boderu/cbEval.PwrSupply.Linear/README.md

# cbEval.PwrSupply.Linear

Evaluation-Board - basierend auf dem modularen Gehäuse von Camdenboss. Stromversorgung mit Linearreglern.
