boderu/cbEval.PwrSupply.Linear/cbEval.PwrSupply.Linear.kicad_pcb

## KiCad design cbEval.PwrSupply.Linear.kicad_pcb (2023-11-08)

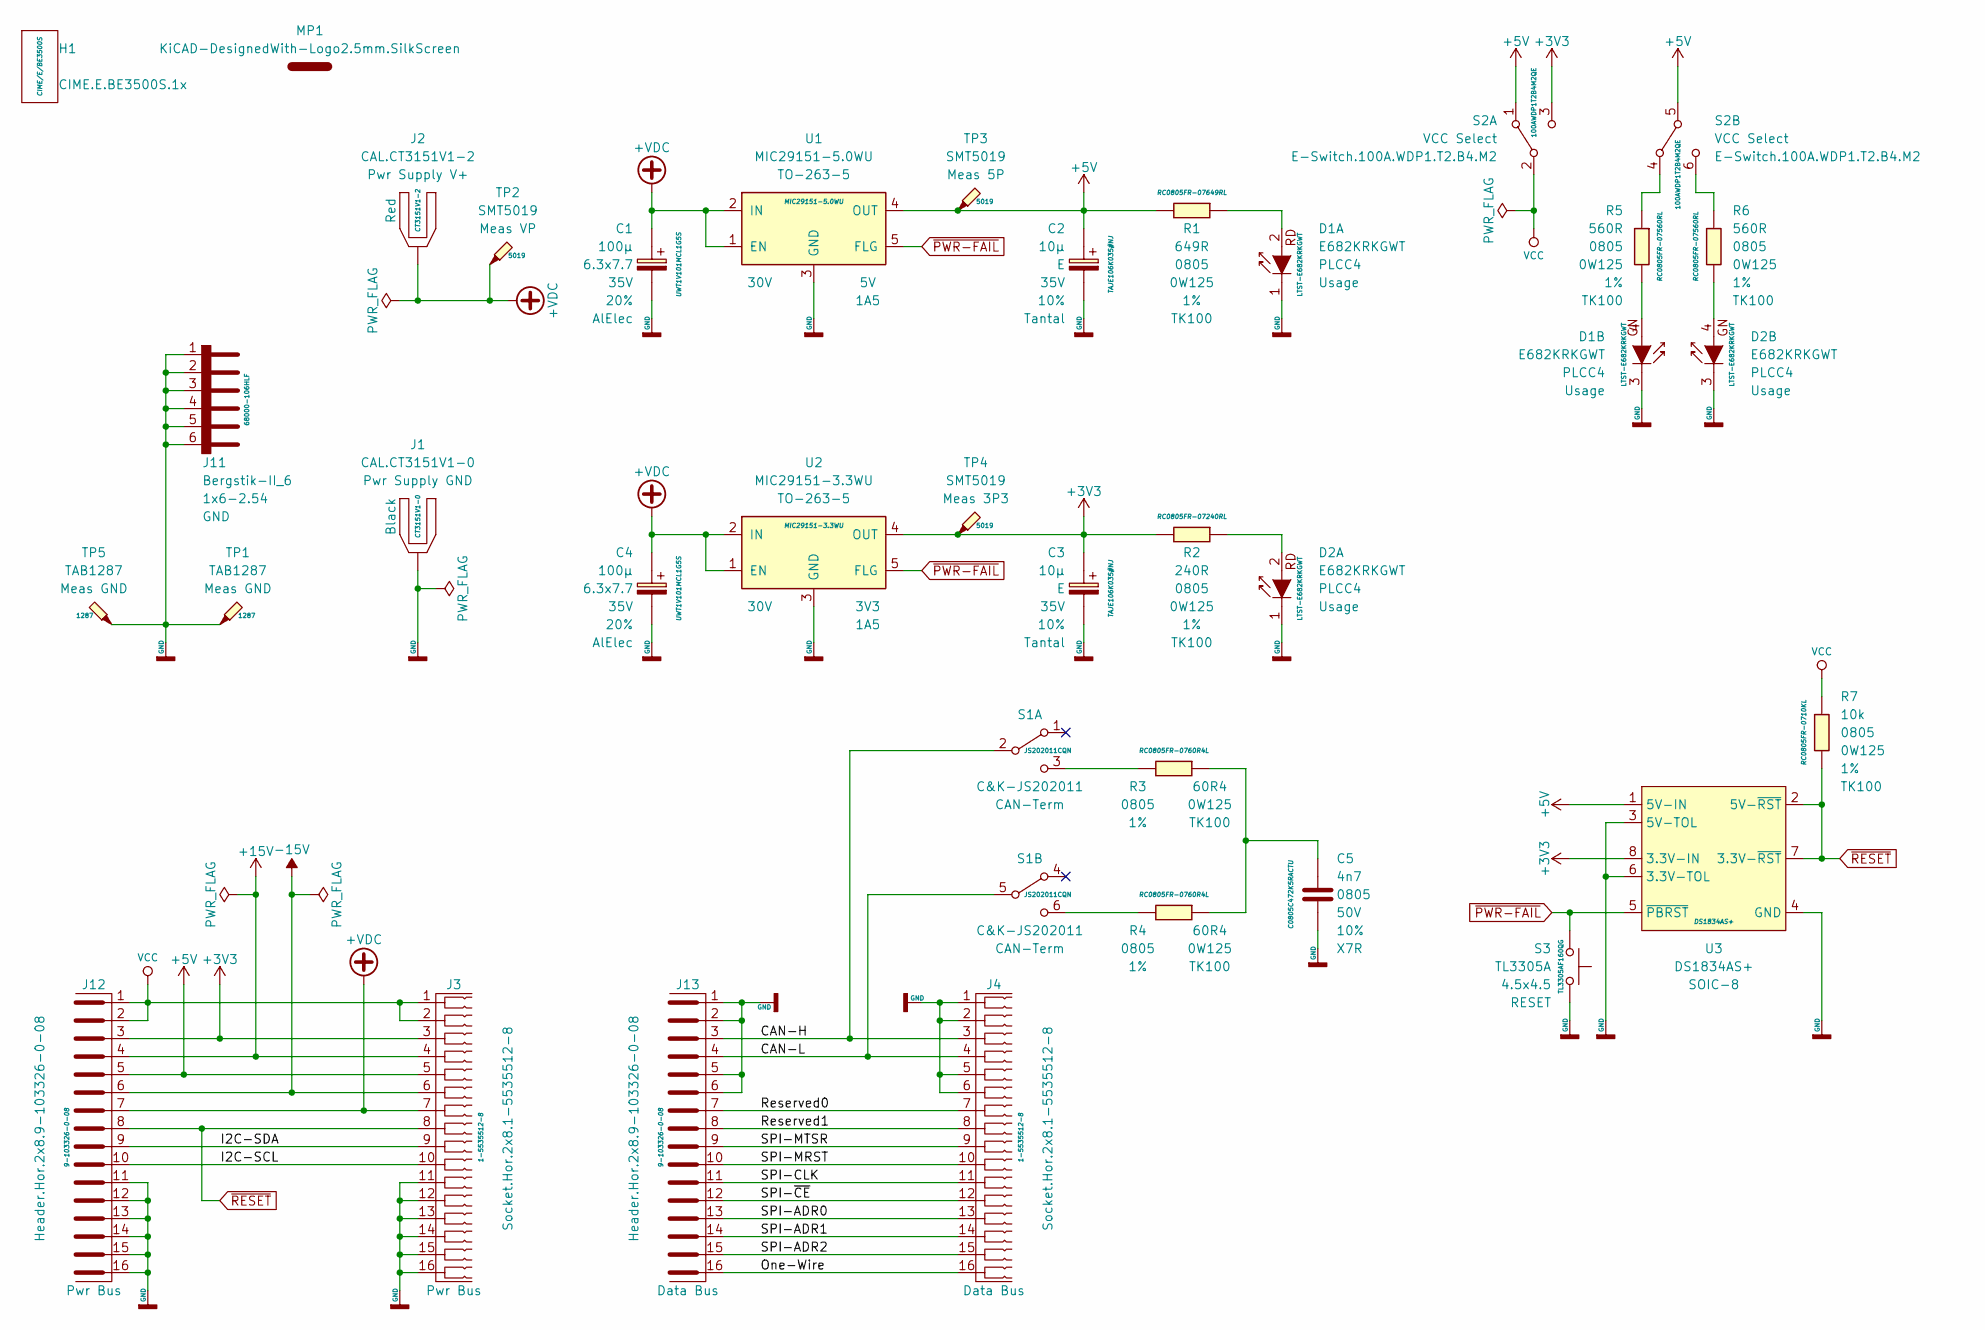
[picture p1: schematic cbEval.PwrSupply.Linear.kicad_sch, cbEval PSupply 5P/3P3]

Parts:
C1, C4: 100µ; CP_Elec_6.3x7.7; Voltage 35V; Tolerance 20%
C2, C3: 10µ; CP_EIA-7360-38_Kemet-E; Voltage 35V; Tolerance 10%
C5: 4n7; C_0805_2012Metric; Voltage 50V; Tolerance 10%
D1, D2: E682KRKGWT; LED_Avago_PLCC4_3.2x2.8mm_CW
H1: CIME.E.BE3500S.1x; Camdenboss.CIME.E.BE3500S.1x
J1: CAL.CT3151V1-0; CAL.CT3151V1
J2: CAL.CT3151V1-2; CAL.CT3151V1
J3, J4: Socket.Hor.2x8.1-5535512-8; Socket.Hor.2x5.6-5535512-4
J11: Bergstik-II_6; PinHeader_1x06_P2.54mm_Vertical
J12, J13: Header.Hor.2x8.9-103326-0-08; PinHeader_2x08_P2.54mm_Horizontal
MP1: KiCAD-DesignedWith-Logo2.5mm.SilkScreen; KiCad-Logo2_5mm_SilkScreen
R1: 649R; R_0805_2012Metric; Tolerance 1%
R2: 240R; R_0805_2012Metric; Tolerance 1%
R3, R4: 60R4; R_0805_2012Metric; Tolerance 1%
R5, R6: 560R; R_0805_2012Metric; Tolerance 1%
R7: 10k; R_0805_2012Metric; Tolerance 1%
S1: C&K-JS202011; SW_CuK_JS202011CQN_DPDT_Straight
S2: E-Switch.100A.WDP1.T2.B4.M2; E-Switch.100A.M2.DPDT
S3: TL3305A; SW_SPST_TL3305A
TP1, TP5: TAB1287; TestPoint_Bridge_Pitch5.08mm_Drill1.3mm
TP2, TP3, TP4: SMT5019; TestPoint_Keystone_5019_Minature
U1: MIC29151-5.0WU; TO-263-5_TabPin3; VoltageIn 30V; VoltageOut 5V
U2: MIC29151-3.3WU; TO-263-5_TabPin3; VoltageIn 30V; VoltageOut 3V3
U3: DS1834AS+; SOIC-8_3.9x4.9mm_P1.27mm

Connections:
+3V3: C3.1, J3.3, J12.3, R2.2, S2.3 (C), TP4.1, U2.4 (OUT), U3.8 (3.3V-IN)
+5V: C2.1, J3.5, J12.5, R1.2, S2.1 (A), S2.5 (B), TP3.1, U1.4 (OUT), U3.1 (5V-IN)
+15V: J3.4, J12.4
+VDC: C1.1, C4.1, J2.1, J3.7, J12.7, TP2.1, U1.1 (EN), U1.2 (IN), U2.1 (EN), U2.2 (IN)
-15V: J3.6, J12.6
/CAN-H: J4.3, J13.3, S1.2 (B)
/CAN-L: J4.4, J13.4, S1.5 (B)
/I2C-SCL: J3.10, J12.10
/I2C-SDA: J3.9, J12.9
/One-Wire: J4.16, J13.16
/Reserved0: J4.7, J13.7
/Reserved1: J4.8, J13.8
/SPI-ADR0: J4.13, J13.13
/SPI-ADR1: J4.14, J13.14
/SPI-ADR2: J4.15, J13.15
/SPI-CLK: J4.11, J13.11
/SPI-MRST: J4.10, J13.10
/SPI-MTSR: J4.9, J13.9
/SPI-~CE: J4.12, J13.12
GND: C1.2, C2.2, C3.2, C4.2, C5.2, D1.1 (Rd-C), D1.3 (Gn-C), D2.1 (Rd-C), D2.3 (Gn-C), J1.1, J3.11, J3.12, J3.13, J3.14, J3.15, J3.16, J4.1, J4.2, J4.5, J4.6, J11.1 (A1), J11.2 (A2), J11.3 (A3), J11.4 (A4), J11.5 (A5), J11.6 (A6), J12.11, J12.12, J12.13, J12.14, J12.15, J12.16, J13.1, J13.2, J13.5, J13.6, S3.2, TP1.1, TP5.1, U1.3 (GND), U2.3 (GND), U3.3 (5V-TOL), U3.4 (GND), U3.6 (3.3V-TOL)
unnamed: C5.1, R3.1, R4.1
unnamed: D1.2 (Rd-A), R1.1
unnamed: D1.4 (Gn-A), R5.2
unnamed: D2.2 (Rd-A), R2.1
unnamed: D2.4 (Gn-A), R6.2
unnamed: R3.2, S1.3 (C)
unnamed: R4.2, S1.6 (C)
unnamed: R5.1, S2.4 (A)
unnamed: R6.1, S2.6 (C)
VCC: J3.1, J3.2, J12.1, J12.2, R7.1, S2.2 (B)
~PWR-FAIL: S3.1, U1.5 (FLG), U2.5 (FLG), U3.5 (~PBRST)
~RESET: J3.8, J12.8, R7.2, U3.2 (5V-~RST), U3.7 (3.3V-~RST)

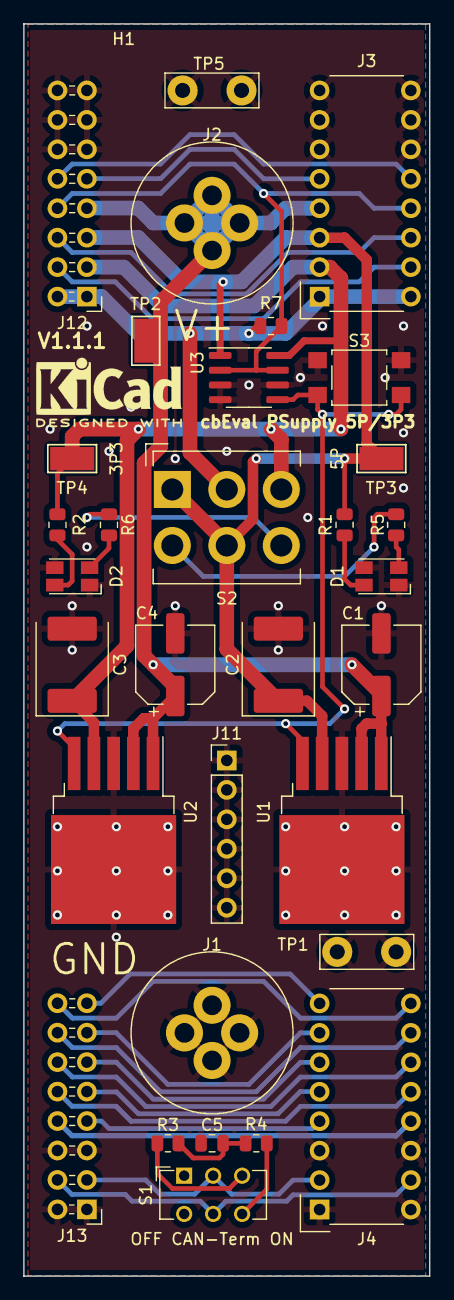
[picture p2: board cbEval.PwrSupply.Linear.kicad_pcb from above]

Board: 2 copper layers, 35.0 x 108.0 mm, 34 parts (0 on the bottom side), 32 nets.
