boderu/cbEval.PwrSupply.Linear/(commit log)

2021-04-03 Schaltplan und grobe Platzierung fertig
    [cbEval.PwrSupply.Linear.kicad_pcb, cbEval.PwrSupply.Linear.kicad_sch]
2021-04-04 Bus-Leitungen neu belegt
    [cbEval.PwrSupply.Linear.kicad_pcb, cbEval.PwrSupply.Linear.kicad_sch]
2021-04-04 Bauteil (PinHeader) ausgetauscht
    [cbEval.PwrSupply.Linear.kicad_pcb, cbEval.PwrSupply.Linear.kicad_sch]
2021-04-10 kleinere Korrekturen vor Bauteilbestellung
    [cbEval.PwrSupply.Linear.csv, cbEval.PwrSupply.Linear.kicad_pcb, cbEval.PwrSupply.Linear.kicad_sch]
2021-04-10 Bus-Stecker getauscht
    [cbEval.PwrSupply.Linear.kicad_pcb, cbEval.PwrSupply.Linear.kicad_sch]
2021-04-11 Properties geändert, Logo aktualisiert
    [cbEval.PwrSupply.Linear.csv, cbEval.PwrSupply.Linear.kicad_pcb, cbEval.PwrSupply.Linear.kicad_sch]
2021-04-18 Layout fertig
    [cbEval.PwrSupply.Linear.kicad_pcb]
2021-06-13 Stromversorgung korrigiert (5P/3P3)
    [cbEval.PwrSupply.Linear.kicad_pcb, cbEval.PwrSupply.Linear.kicad_sch]
2021-07-18 gespeichert im neuen Format
    [cbEval.PwrSupply.Linear.kicad_pcb, cbEval.PwrSupply.Linear.kicad_sch]
2021-12-27 Auf das Datenformat der Version 6 umgestellt
    [cbEval.PwrSupply.Linear.kicad_pcb, cbEval.PwrSupply.Linear.kicad_sch]
2022-01-22 Position von Steckern ausgerückt, SilkScreen von Steckern verändert
    [cbEval.PwrSupply.Linear.kicad_pcb, cbEval.PwrSupply.Linear.kicad_sch]
2022-02-05 Widerstandswerte zur Ansteuerung derngrünen LEDs auf 560 Ohm verringert. Neue Version 1.1.1
    [cbEval.PwrSupply.Linear.kicad_pcb, cbEval.PwrSupply.Linear.kicad_sch]
2023-11-08 Update auf KiCAD Version 7
    [cbEval.PwrSupply.Linear.kicad_pcb, cbEval.PwrSupply.Linear.kicad_sch]
